gabibranche/performing-robots/final-project/journal-entry_11.19.19/Wiring1.jpg

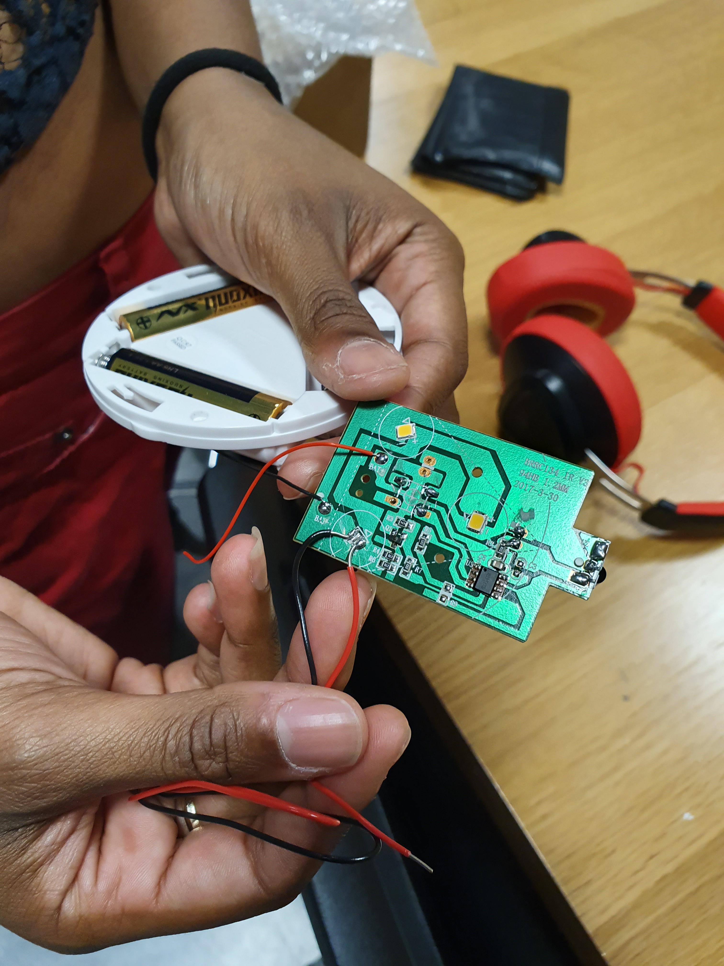
[picture p16: final-project/journal-entry_11.19.19/Wiring1.jpg]
final-project/journal-entry_11.19.19/Wiring1.jpg
